TheDuck0s/isa_FDC-CF-USB/isa_FDC-CF-USB_Schematic.pdf

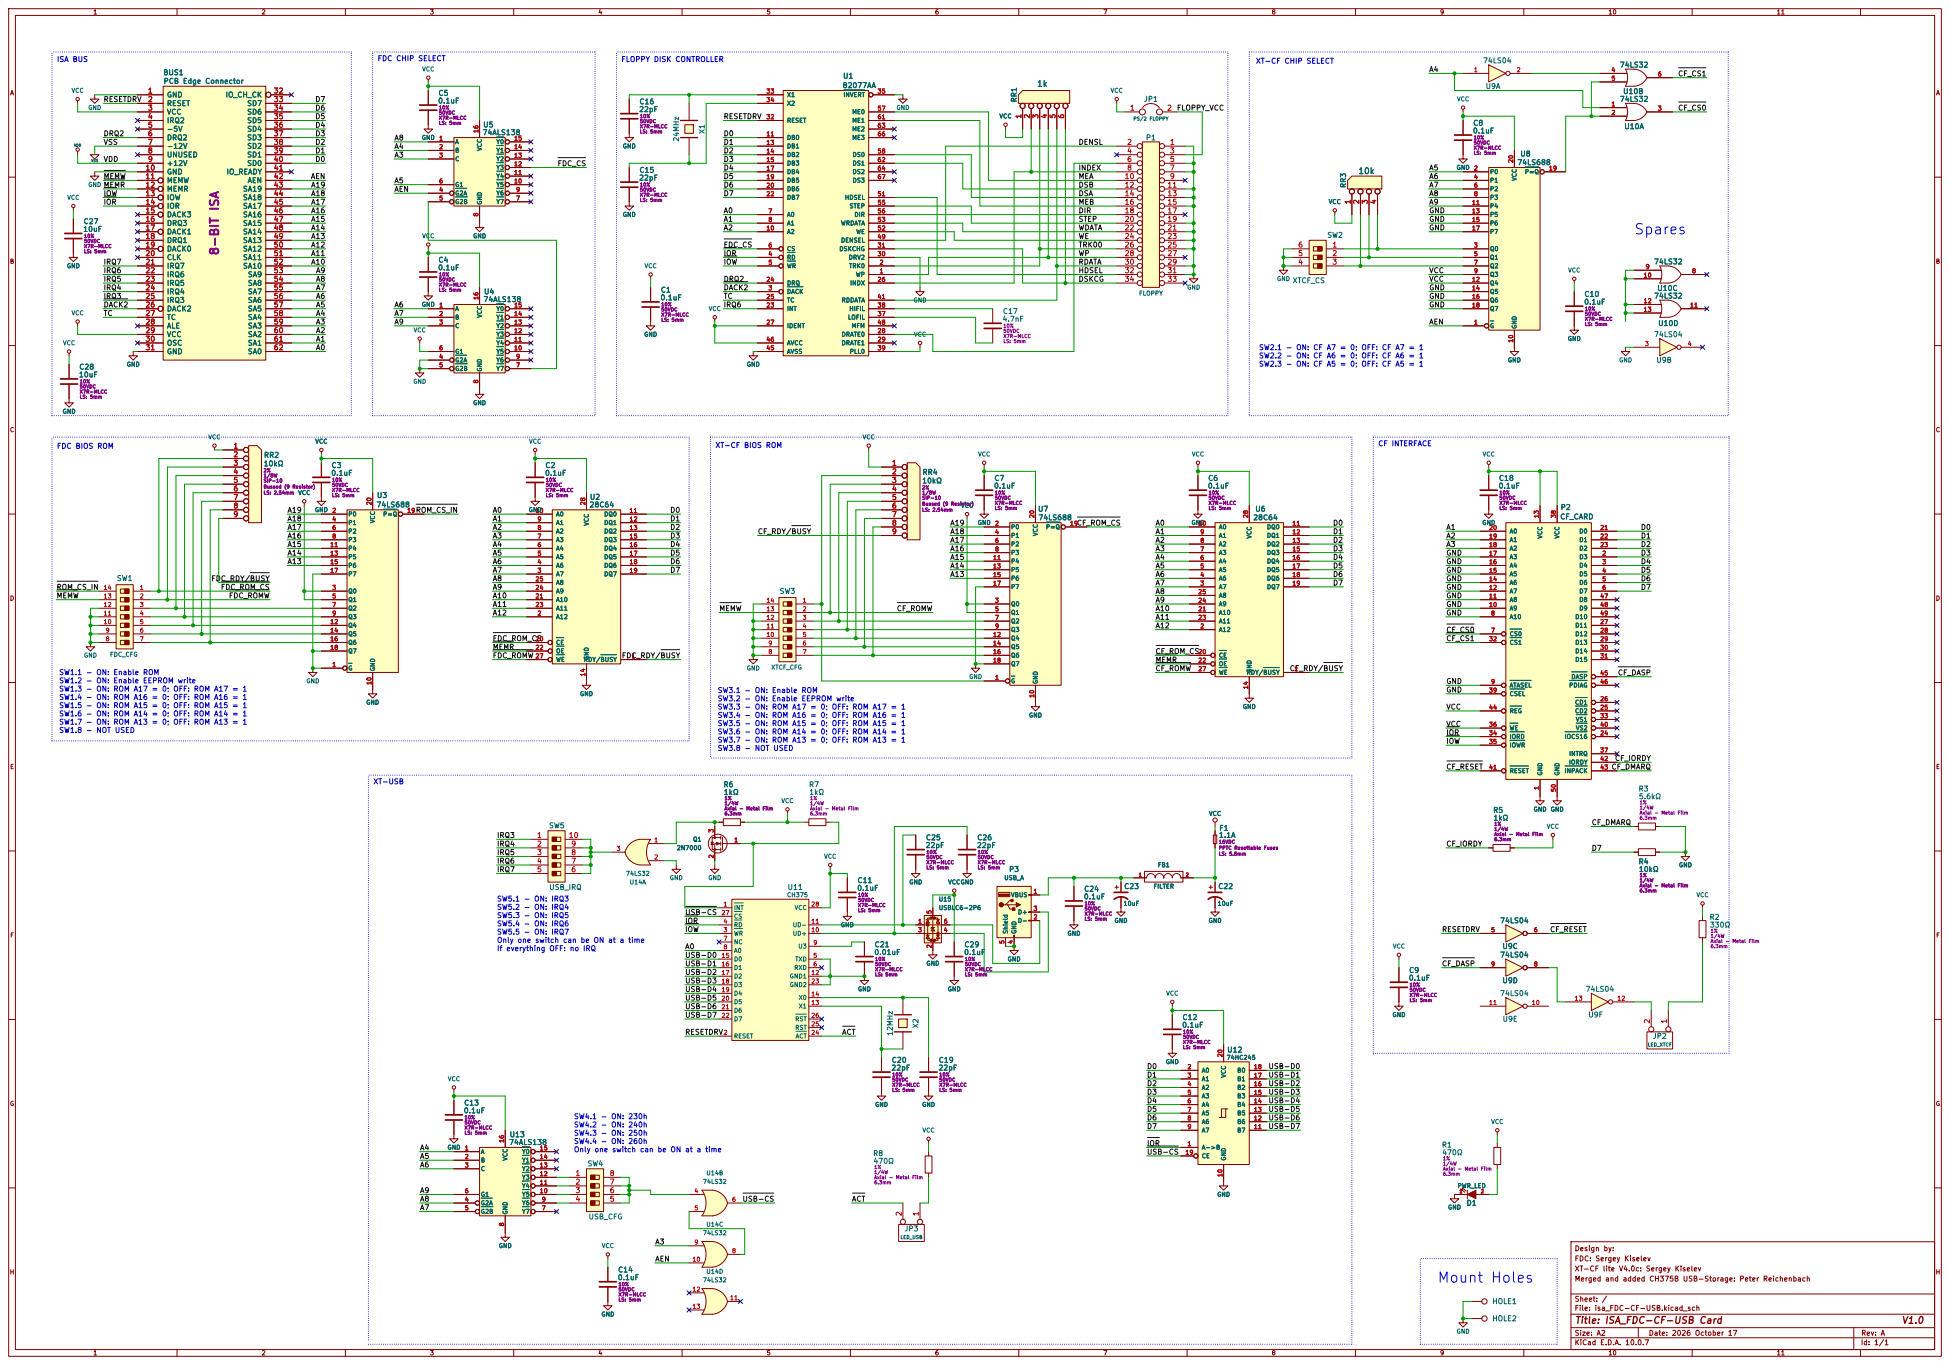
[picture p2: page 1]

PCB Edge Connector 8-BIT ISA

GND 1
RESET 2

XT-CF CHIP SELECT

SW2.1 - ON: CF A7 = 0; OFF: CF A7 = 1
SW2.2 - ON: CF A6 = 0; OFF: CF A6 = 1
SW2.3 - ON: CF A5 = 0; OFF: CF A5 = 1

XT-CF BIOS ROM

11 | 4
10 | 5

12 | 3

SW1.1 - ON: Enable ROM
SW1.2 - ON: Enable EEPROM write
SW1.3 - ON: ROM A17 = 0; OFF: ROM A17 = 1
SW1.4 - ON: ROM A16 = 0; OFF: ROM A16 = 1
SW1.5 - ON: ROM A15 = 0; OFF: ROM A15 = 1
SW1.6 - ON: ROM A14 = 0; OFF: ROM A14 = 1
SW1.7 - ON: ROM A13 = 0; OFF: ROM A13 = 1
SW1.8 - NOT USED

SW3.1 - ON: Enable ROM
SW3.2 - ON: Enable EEPROM write
SW3.3 - ON: ROM A17 = 0; OFF: ROM A17 = 1
SW3.4 - ON: ROM A16 = 0; OFF: ROM A16 = 1
SW3.5 - ON: ROM A15 = 0; OFF: ROM A15 = 1
SW3.6 - ON: ROM A14 = 0; OFF: ROM A14 = 1
SW3.7 - ON: ROM A13 = 0; OFF: ROM A13 = 1
SW3.8 - NOT USED

SW5.1 - ON: IRQ3
SW5.2 - ON: IRQ4
SW5.3 - ON: IRQ5
SW5.4 - ON: IRQ6
SW5.5 - ON: IRQ7
Only one switch can be ON at a time
If everything OFF: no IRQ

Design by:
FDC: Sergey Kiselev
XT-CF lite V4.0c: Sergey Kiselev
Merged and added CH375B USB-Storage: Peter Reichenbach

Size: A2 | Rev: A
KiCad E.D.A. 10.0.7 | Id: 1/1
