TheDuck0s/isa_FDC-CF-USB/isa_FDC-CF-USB_Board_Design.pdf

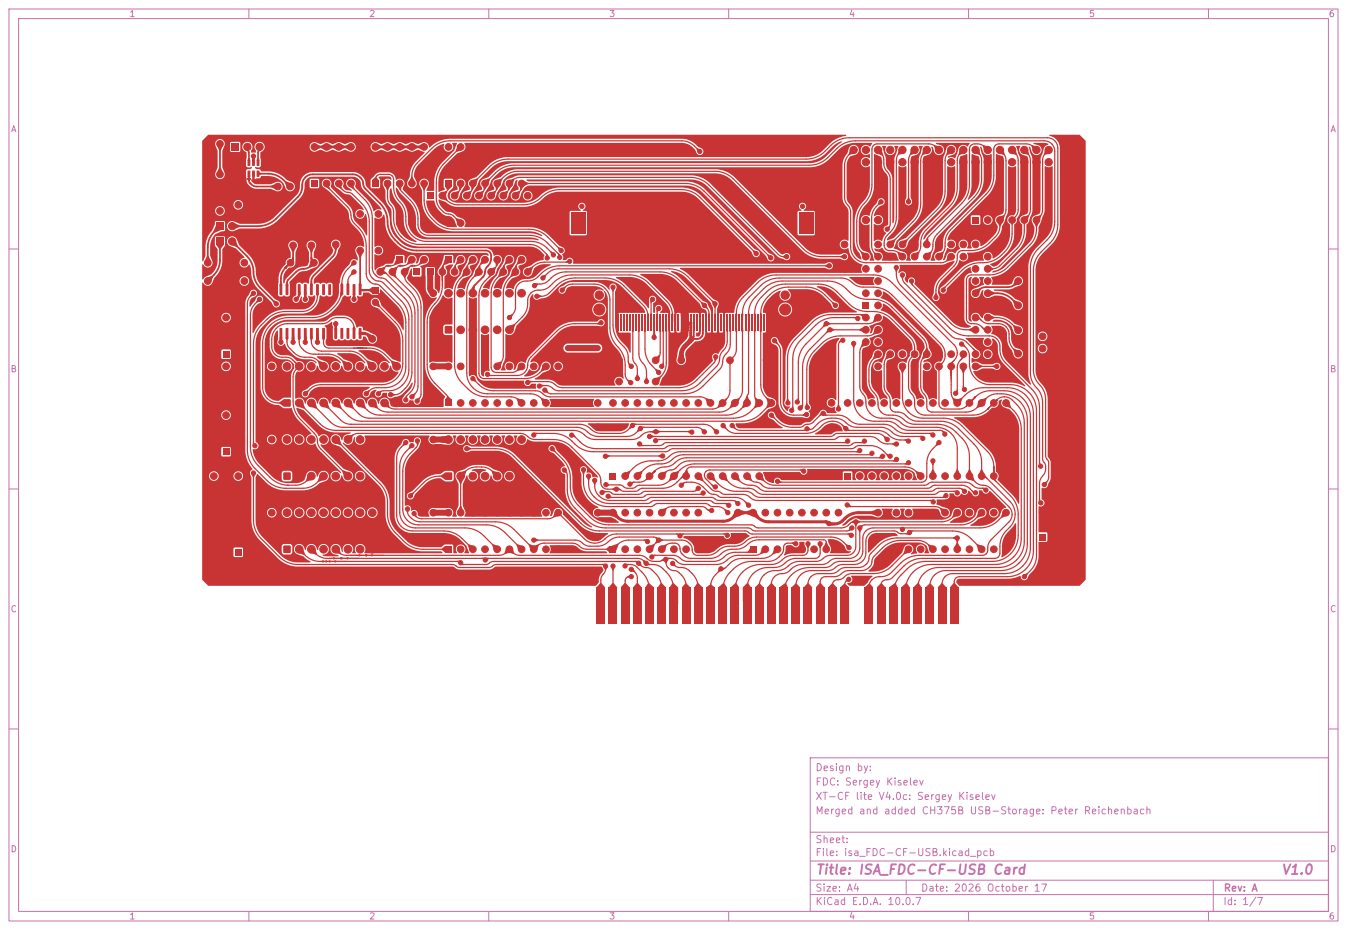
[picture p3: page 1]

Design by:
FDC: Sergey Kiselev
XT-CF lite V4.0c: Sergey Kiselev
Merged and added CH375B USB-Storage: Peter Reichenbach

Size: A4 | Rev: A
KiCad E.D.A. 10.0.7 | Id: 1/7

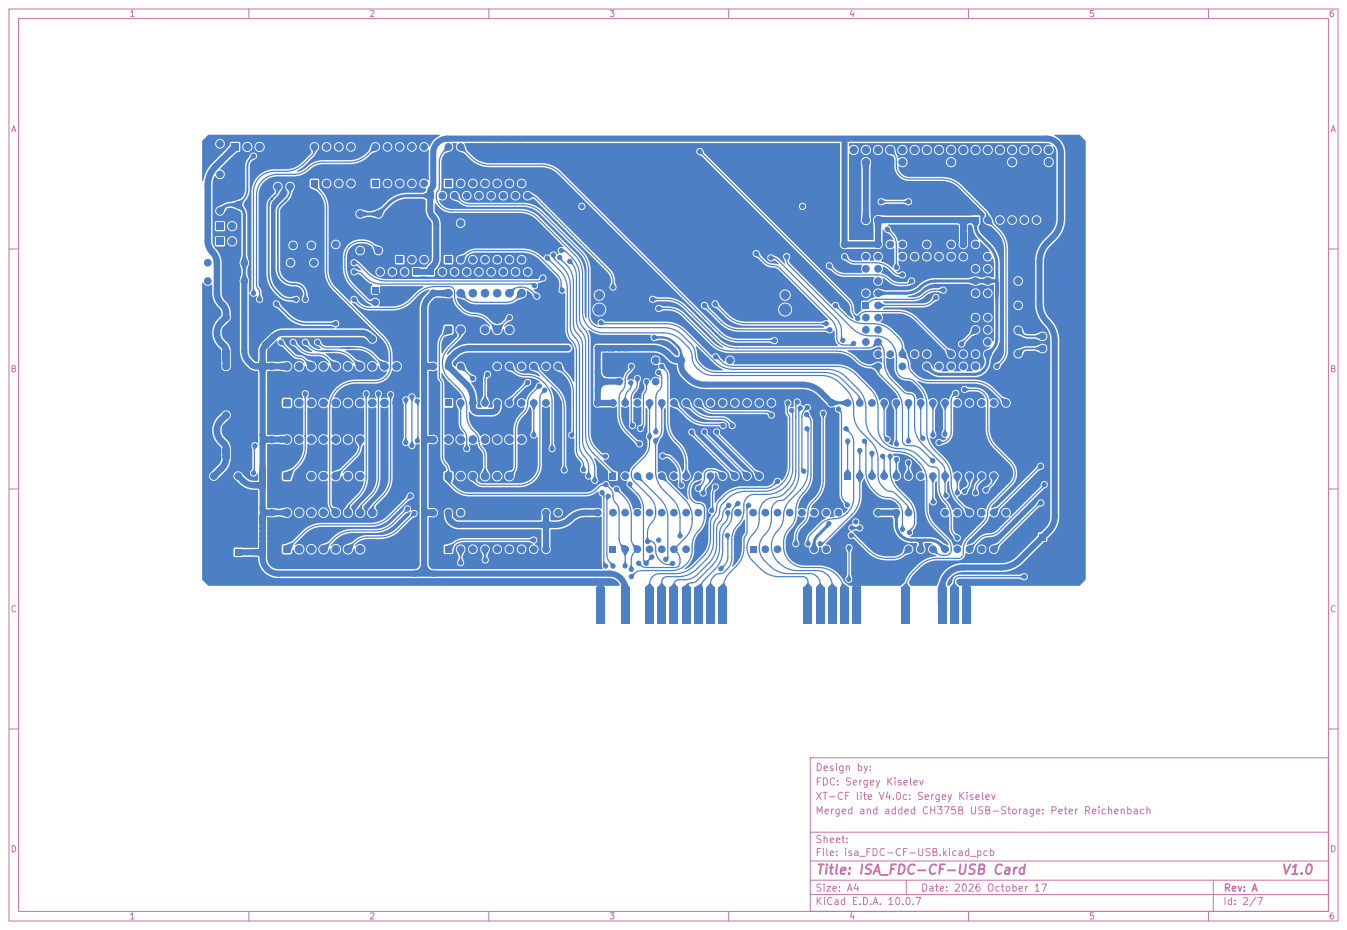
[picture p4: page 2]
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

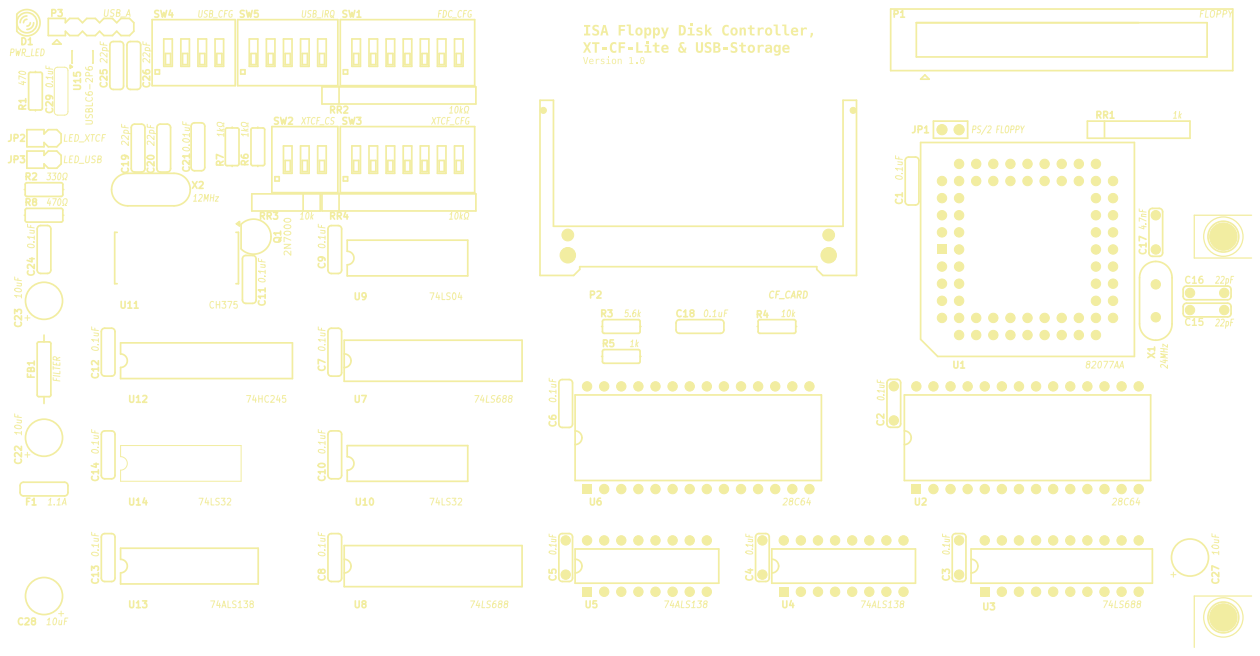
[picture p5: page 3]
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

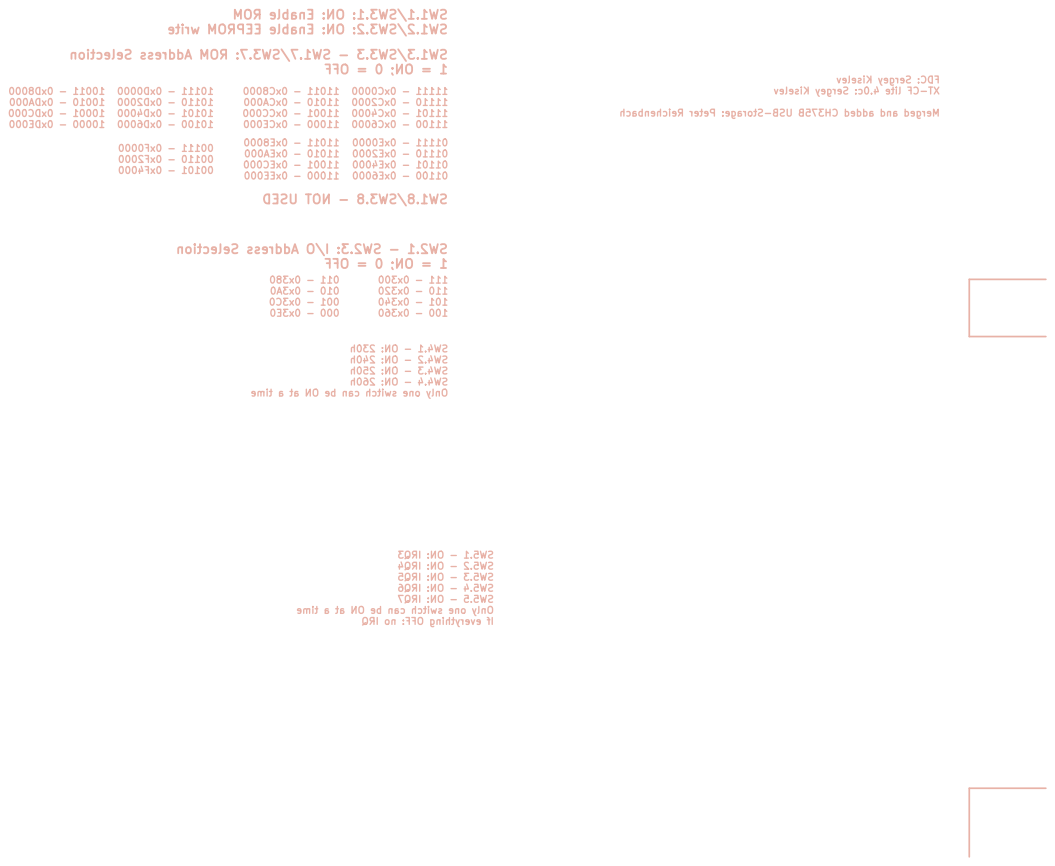
[picture p6: page 4]
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

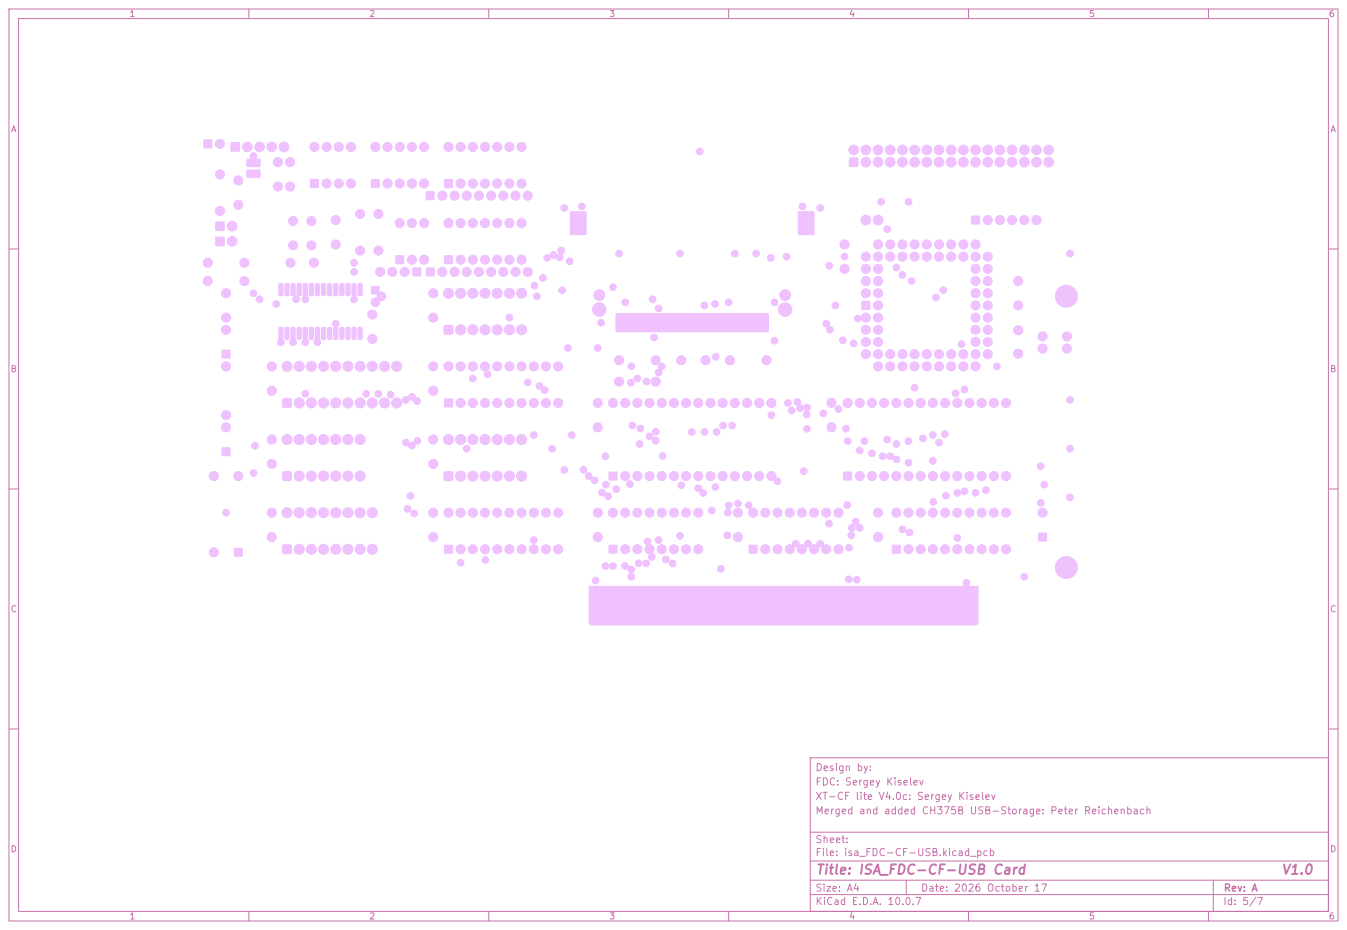
[picture p7: page 5]
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

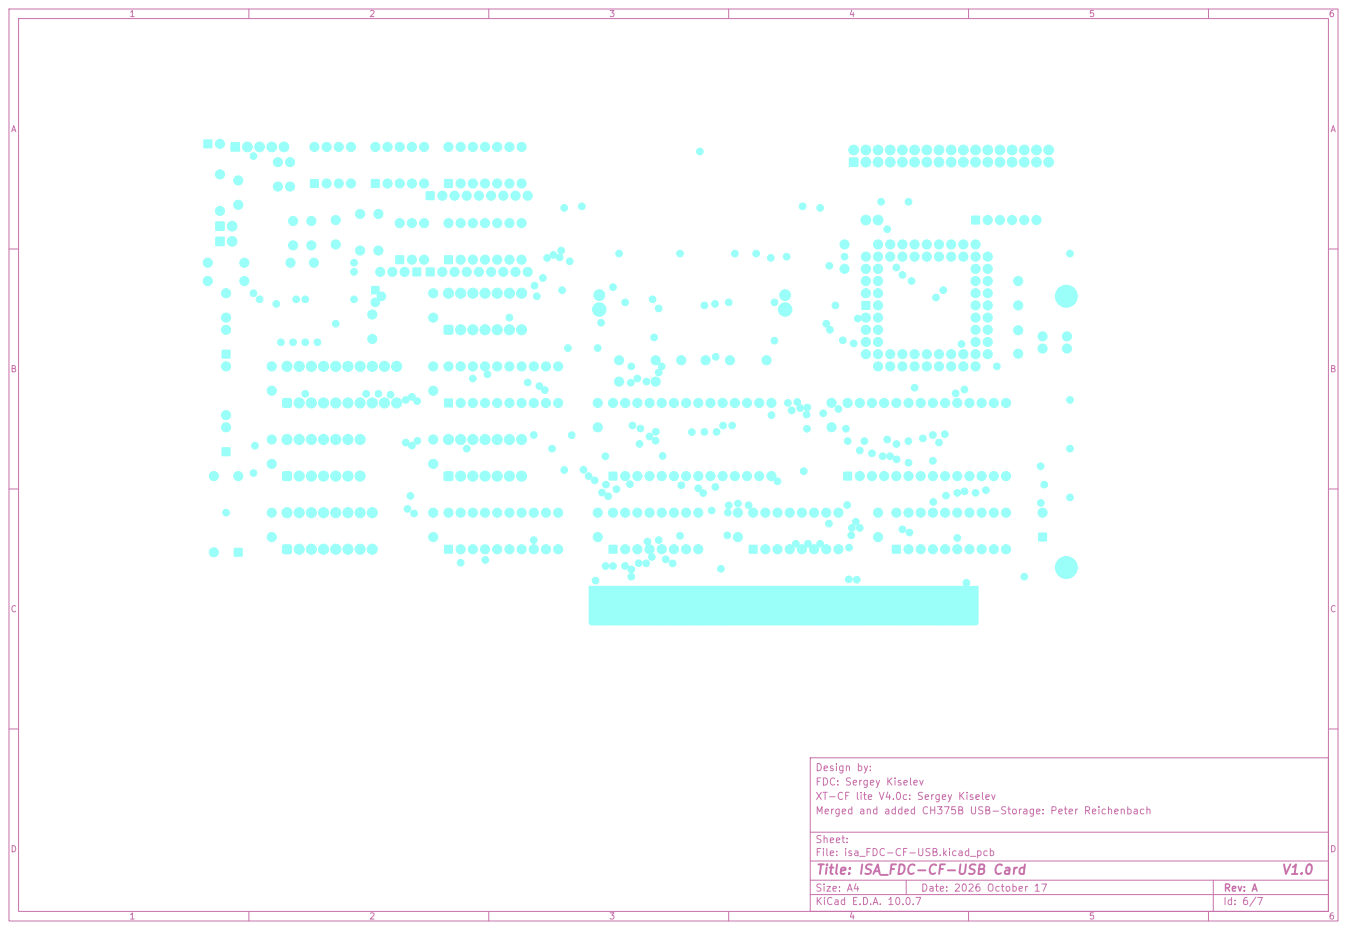
[picture p8: page 6]
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

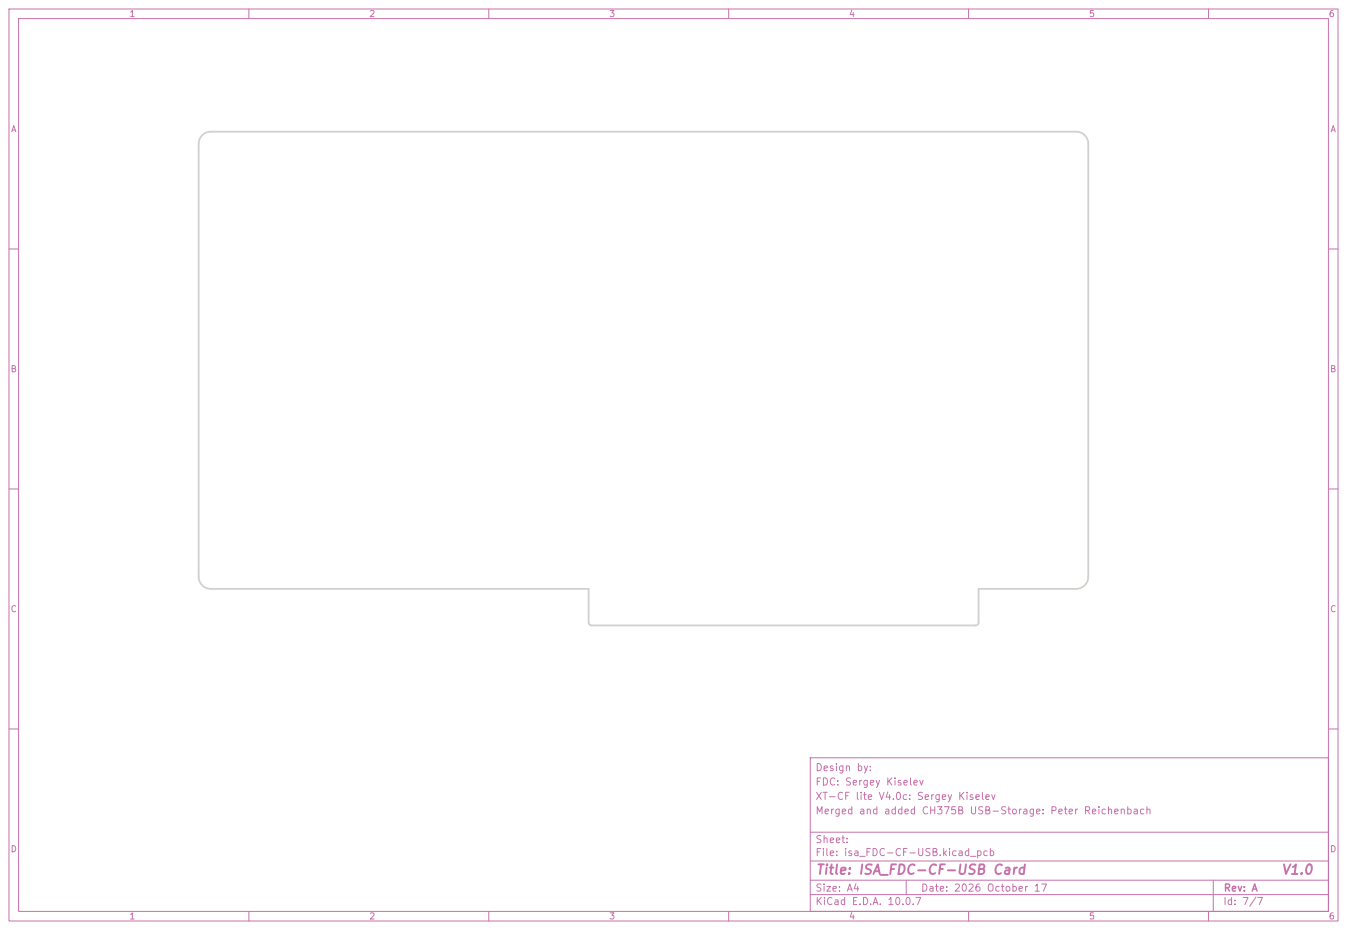
[picture p9: page 7]
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
