TheDuck0s/isa_FDC-CF-USB/Kicad/isa_FDC-CF-USB.kicad_pcb

## KiCad design Kicad/isa_FDC-CF-USB.kicad_pcb (2026-10-17)

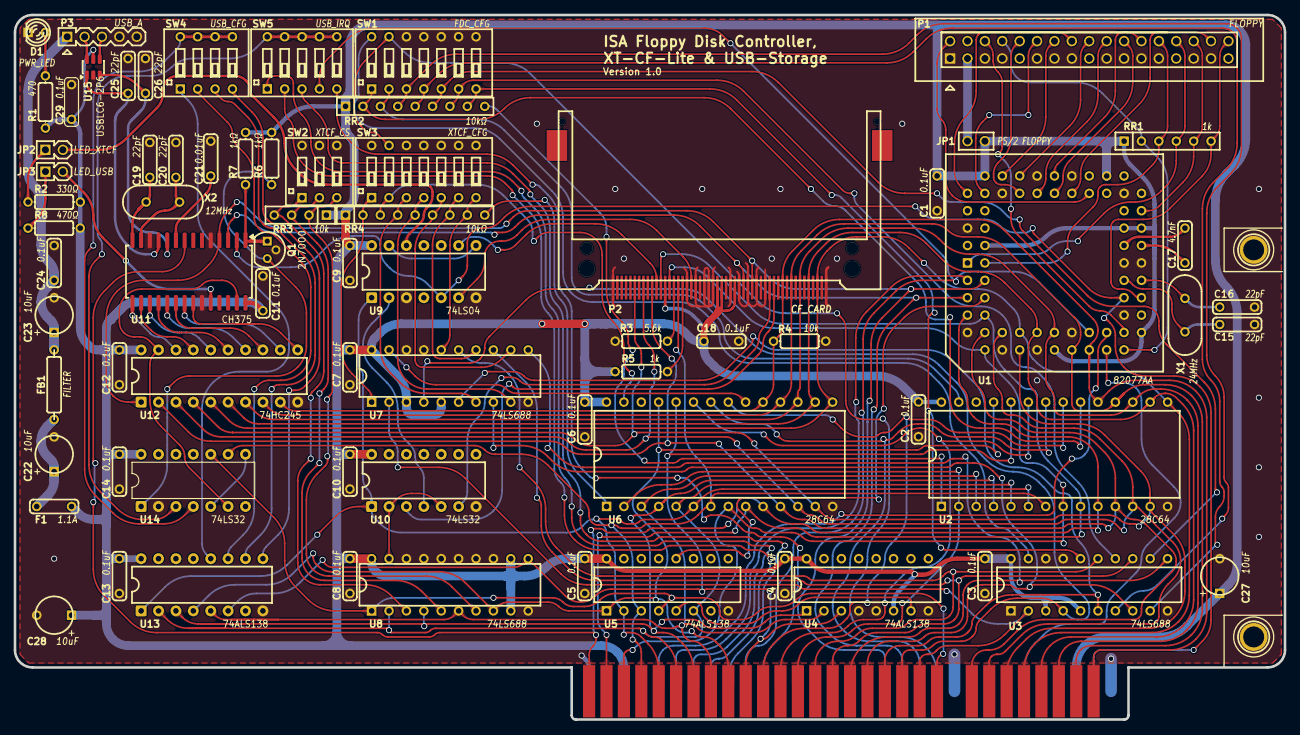
[picture p10: board isa_FDC-CF-USB.kicad_pcb from above]

Board: 2 copper layers, 185.4 x 102.9 mm, 76 parts (0 on the bottom side), 130 nets.

Parts:
BUS1: PCB Edge Connector; Conn_Bus_ISA8
C1, C6, C7, C8, C9, C10, C11, C12, C13, C14, C18, C24, C29: 0.1uF; Cap_Cer_508
C2, C3, C4, C5: 0.1uF; Cap_Cer_504
C15, C16: 22pF; Cap_Cer_504
C17: 4.7nF; Cap_Cer_504
C19, C20, C25, C26: 22pF; Cap_Cer_508
C21: 0.01uF; Cap_Cer_508
C22, C23, C27, C28: 10uF; Cap_Tant_508
D1: PWR_LED; LED_3mm
F1: 1.1A; Cap_Cer_508
FB1: FILTER; Res_1016
HOLE1, HOLE2: CONN_1; HOLE_3MM
JP1: PS/2 FLOPPY; Conn_Pin_Header_2x1_Nokey
JP2: LED_XTCF; Conn_Pin_Header_2x1_2.54mm
JP3: LED_USB; Conn_Pin_Header_2x1_2.54mm
P1: FLOPPY; Conn_Pin_Header_17x2_2.54mm_Shrouded
P2: CF_CARD; Conn_CF_N7E50-Q516XX-40
P3: USB_A; Conn_Pin_Header_5x1_2.54mm
Q1: 2N7000; TO-92
R1: 470; Res_762
R2: 330Ω; Res_762
R3: 5.6k; Res_762
R4: 10k; Res_762
R5: 1k; Res_762
R6, R7: 1kΩ; Res_762
R8: 470Ω; Res_762
RR1: 1k; Conn_SIL6
RR2, RR4: 10kΩ; Conn_SIL9
RR3: 10k; Conn_SIL5
SW1: FDC_CFG; Switch_DIP_7_Positions
SW2: XTCF_CS; Switch_DIP_3_Positions
SW3: XTCF_CFG; Switch_DIP_7_Positions
SW4: USB_CFG; Switch_DIP_4_Positions
SW5: USB_IRQ; Switch_DIP_5_Positions
U1: 82077AA; PLCC68_TH
U2: 28C64; DIP28_600
U3: 74LS688; DIP20_300
U4, U5: 74ALS138; DIP16_300
U6: 28C64; IC_DIP28_600
U7, U8: 74LS688; IC_DIP20_300
U9: 74LS04; DIP-14_W7.62mm
U10, U14: 74LS32; DIP-14_W7.62mm
U11: CH375; SOP-28_8.4x18.16mm_P1.27mm
U12: 74HC245; DIP-20_W7.62mm
U13: 74ALS138; DIP-16_W7.62mm
U15: USBLC6-2P6; SOT-23-6
X1: 24MHz; Crystal_HC-49U_Vert
X2: 12MHz; Crystal_HC-49U_Vert

Connections:
/A0: BUS1.62 (SA0), U1.7 (A0), U2.10 (A0), U6.10 (A0), U11.8 (A0)
/A1: BUS1.61 (SA1), P2.20 (A0), U1.8 (A1), U2.9 (A1), U6.9 (A1)
/A2: BUS1.60 (SA2), P2.19 (A1), U1.10 (A2), U2.8 (A2), U6.8 (A2)
/A3: BUS1.59 (SA3), P2.18 (A2), U2.7 (A3), U5.3 (C), U6.7 (A3), U14.9
/A4: BUS1.58 (SA4), U2.6 (A4), U5.2 (B), U6.6 (A4), U9.1, U10.1, U13.1 (A)
/A5: BUS1.57 (SA5), U2.5 (A5), U5.6 (G1), U6.5 (A5), U8.2 (P0), U13.2 (B)
/A6: BUS1.56 (SA6), U2.4 (A6), U4.1 (A), U6.4 (A6), U8.4 (P1), U13.3 (C)
/A7: BUS1.55 (SA7), U2.3 (A7), U4.2 (B), U6.3 (A7), U8.6 (P2), U13.5 (~G2B)
/A8: BUS1.54 (SA8), U2.25 (A8), U5.1 (A), U6.25 (A8), U8.8 (P3), U13.4 (~G2A)
/A9: BUS1.53 (SA9), U2.24 (A9), U4.3 (C), U6.24 (A9), U8.11 (P4), U13.6 (G1)
/A10: BUS1.52 (SA10), U2.21 (A10), U6.21 (A10)
/A11: BUS1.51 (SA11), U2.23 (A11), U6.23 (A11)
/A12: BUS1.50 (SA12), U2.2 (A12), U6.2 (A12)
/A13: BUS1.49 (SA13), U3.15 (P6), U7.15 (P6)
/A14: BUS1.48 (SA14), U3.13 (P5), U7.13 (P5)
/A15: BUS1.47 (SA15), U3.11 (P4), U7.11 (P4)
/A16: BUS1.46 (SA16), U3.8 (P3), U7.8 (P3)
/A17: BUS1.45 (SA17), U3.6 (P2), U7.6 (P2)
/A18: BUS1.44 (SA18), U3.4 (P1), U7.4 (P1)
/A19: BUS1.43 (SA19), U3.2 (P0), U7.2 (P0)
/AEN: BUS1.42 (AEN), U5.4 (~G2A), U8.1 (~G), U14.10
/CF_DMARQ: P2.43 (~INPACK), R3.1
/CF_IORDY: P2.42 (IORDY), R5.1
/CF_RDY/~BUSY: RR4.9, U6.1 (RDY/~BUSY)
/D0: BUS1.40 (SD0), P2.21 (D0), U1.11 (DB0), U2.11 (DQ0), U6.11 (DQ0), U12.2 (A0)
/D1: BUS1.39 (SD1), P2.22 (D1), U1.13 (DB1), U2.12 (DQ1), U6.12 (DQ1), U12.3 (A1)
/D2: BUS1.38 (SD2), P2.23 (D2), U1.14 (DB2), U2.13 (DQ2), U6.13 (DQ2), U12.4 (A2)
/D3: BUS1.37 (SD3), P2.2 (D3), U1.15 (DB3), U2.15 (DQ3), U6.15 (DQ3), U12.5 (A3)
/D4: BUS1.36 (SD4), P2.3 (D4), U1.17 (DB4), U2.16 (DQ4), U6.16 (DQ4), U12.6 (A4)
/D5: BUS1.35 (SD5), P2.4 (D5), U1.19 (DB5), U2.17 (DQ5), U6.17 (DQ5), U12.7 (A5)
/D6: BUS1.34 (SD6), P2.5 (D6), U1.20 (DB6), U2.18 (DQ6), U6.18 (DQ6), U12.8 (A6)
/D7: BUS1.33 (SD7), P2.6 (D7), R4.1, U1.22 (DB7), U2.19 (DQ7), U6.19 (DQ7), U12.9 (A7)
/DENSL: P1.2, U1.49 (DENSEL)
/DIR: P1.18, U1.56 (DIR)
/DRQ2: BUS1.6 (DRQ2), U1.24 (DRQ)
/DSA: P1.14, U1.58 (DS0)
/DSB: P1.12, U1.62 (DS1)
/DSKCG: P1.34, RR1.6, U1.31 (DSKCHG)
/FDC_RDY/~BUSY: RR2.9, U2.1 (RDY/~BUSY)
/FLOPPY_VCC: JP1.2, P1.3
/HDSEL: P1.32, U1.51 (HDSEL)
/INDEX: P1.8, RR1.2, U1.26 (INDX)
/IRQ3: BUS1.25 (IRQ3), SW5.1
/IRQ4: BUS1.24 (IRQ4), SW5.2
/IRQ5: BUS1.23 (IRQ5), SW5.3
/IRQ6: BUS1.22 (IRQ6), SW5.4, U1.23 (INT)
/IRQ7: BUS1.21 (IRQ7), SW5.5
/MEA: P1.10, U1.57 (ME0)
/MEB: P1.16, U1.61 (ME1)
/RDATA: P1.30, RR1.5, U1.41 (RDDATA)
/RESETDRV: BUS1.2 (RESET), U1.32 (RESET), U9.5, U11.2 (RESET)
/STEP: P1.20, U1.55 (STEP)
/TC: BUS1.27 (TC), U1.25 (TC)
/TRK00: P1.26, RR1.3, U1.2 (TRK0)
/USB-D0: U11.15 (D0), U12.18 (B0)
/USB-D1: U11.16 (D1), U12.17 (B1)
/USB-D2: U11.17 (D2), U12.16 (B2)
/USB-D3: U11.18 (D3), U12.15 (B3)
/USB-D4: U11.19 (D4), U12.14 (B4)
/USB-D5: U11.20 (D5), U12.13 (B5)
/USB-D6: U11.21 (D6), U12.12 (B6)
/USB-D7: U11.22 (D7), U12.11 (B7)
/WDATA: P1.22, U1.53 (WRDATA)
/WE: P1.24, U1.52 (WE)
/WP: P1.28, RR1.4, U1.1 (WP)
/~ACT: JP3.2 (PM), U11.24 (~ACT)
/~CF_CS0: P2.7 (~CS0), U10.3
/~CF_CS1: P2.32 (~CS1), U10.6
/~CF_DASP: P2.45 (~DASP), U9.9
/~CF_RESET: P2.41 (~RESET), U9.6
/~CF_ROMW: RR4.3, SW3.2, U6.27 (~WE)
/~CF_ROM_CS: U6.20 (~CE), U7.19 (~P=Q)
/~DACK2: BUS1.26 (DACK2), U1.3 (~DACK)
/~FDC_CS: U1.6 (CS), U5.12 (~Y3)
/~FDC_ROMW: RR2.3, SW1.2, U2.27 (~WE)
/~FDC_ROM_CS: RR2.2, SW1.1, U2.20 (~CE)
/~IOR: BUS1.14 (IOR), P2.34 (~IORD), U1.4 (~RD), U11.4 (~RD), U12.1 (A->B)
/~IOW: BUS1.13 (IOW), P2.35 (~IOWR), U1.5 (~WR), U11.3 (~WR)
/~MEMR: BUS1.12 (MEMR), U2.22 (~OE), U6.22 (~OE)
/~MEMW: BUS1.11 (MEMW), SW1.13, SW3.13
/~ROM_CS_IN: SW1.14, U3.19 (~P=Q)
/~USB-CS: U11.27 (~CS), U12.19 (CE), U14.6
GND: BUS1.1 (GND), BUS1.10 (GND), BUS1.31 (GND), C1.2, C2.2, C3.2, C4.2, C5.2, C6.2, C7.2, C8.2, C9.2, C10.2, C11.1, C12.2, C13.2, C14.2, C15.2, C16.2, C18.2, C19.2, C20.2, C21.2, C22.2, C23.2, C24.2, C25.2, C26.2, C27.2, C28.2, C29.2, D1.1 (K), HOLE1.1 (1_1), HOLE2.1 (1_1), P1.1, P1.5, P1.7, P1.11, P1.13, P1.15, P1.19, P1.21, P1.23, P1.25, P1.29, P1.31, P2.1 (GND), P2.8 (A10), P2.9 (~ATASEL), P2.10 (A9), P2.11 (A8), P2.12 (A7), P2.14 (A6), P2.15 (A5), P2.16 (A4), P2.17 (A3), P2.39 (~CSEL), P2.50 (GND), P3.4 (GND), P3.5 (Shield), Q1.2 (S), R3.2, R4.2, SW1.8, SW1.9, SW1.10, SW1.11, SW1.12, SW2.4, SW2.5, SW2.6, SW3.8, SW3.9, SW3.10, SW3.11, SW3.12, SW3.14, U1.9 (GND), U1.12 (GND), U1.16 (GND), U1.21 (GND), U1.30 (DRV2), U1.35 (~INVERT), U1.36 (GND), U1.45 (AVSS), U1.50 (GND), U1.54 (GND), U1.59 (GND), U1.65 (GND), U2.14 (GND), U3.1 (~G), U3.10 (GND), U3.17 (P7), U3.18 (Q7), U4.4 (~G2A), U4.5 (~G2B), U4.8 (GND), U5.8 (GND), U6.14 (GND), U7.10 (GND), U7.17 (P7), U7.18 (Q7), U8.10 (GND), U8.13 (P5), U8.14 (Q5), U8.15 (P6), U8.16 (Q6), U8.17 (P7), U8.18 (Q7), U9.3, U9.7 (GND), U10.7 (GND), U11.5 (TXD), U11.12 (GND1), U11.23 (GND2), U12.10 (GND), U13.8 (GND), U14.2, U15.2 (GND)
unnamed: C22.1, F1.1, FB1.2
unnamed: D1.2 (A), R1.1
unnamed: JP2.1, R2.2
unnamed: JP2.2 (PM), U9.12
unnamed: JP3.1, R8.2
unnamed: P1.6, U1.28 (DRATE0)
unnamed: P3.3 (D+), U15.4 (I/O2)
unnamed: P3.2 (D-), U15.6 (I/O1)
unnamed: C23.1, C24.1, FB1.1, P3.1 (VBUS)
unnamed: Q1.3 (D), R6.2, U14.1
unnamed: Q1.1 (G), R7.1, U11.1 (~INT)
unnamed: SW4.5, SW4.6, SW4.7, SW4.8, U14.4
unnamed: SW5.6, SW5.7, SW5.8, SW5.9, SW5.10, U14.3
unnamed: C17.1, U1.38 (HIFIL)
unnamed: C17.2, U1.37 (LOFIL)
unnamed: C16.1, U1.33 (X1), X1.1
unnamed: C15.1, U1.34 (X2), X1.2
unnamed: RR2.4, SW1.3, U3.7 (Q2)
unnamed: RR2.5, SW1.4, U3.9 (Q3)
unnamed: RR2.6, SW1.5, U3.12 (Q4)
unnamed: RR2.7, SW1.6, U3.14 (Q5)
unnamed: RR2.8, SW1.7, U3.16 (Q6)
unnamed: U4.7 (~Y7), U5.5 (~G2B)
unnamed: RR4.4, SW3.3, U7.7 (Q2)
unnamed: RR4.5, SW3.4, U7.9 (Q3)
unnamed: RR4.6, SW3.5, U7.12 (Q4)
unnamed: RR4.7, SW3.6, U7.14 (Q5)
unnamed: RR4.8, SW3.7, U7.16 (Q6)
unnamed: RR4.2, SW3.1, U7.1 (~G)
unnamed: RR3.4, SW2.1, U8.3 (Q0)
unnamed: RR3.3, SW2.2, U8.5 (Q1)
unnamed: RR3.2, SW2.3, U8.7 (Q2)
unnamed: U8.19 (~P=Q), U10.2, U10.5
unnamed: U9.8, U9.13
unnamed: U9.2, U10.4
unnamed: U10.9, U10.10, U10.12, U10.13
unnamed: C21.1, U11.9 (U3)
unnamed: C26.1, U11.10 (UD+), U15.3 (I/O2)
unnamed: C25.1, U11.11 (UD-), U15.1 (I/O1)
unnamed: C19.1, U11.14 (X0), X2.1
unnamed: C20.1, U11.13 (X1), X2.2
unnamed: SW4.1, U13.12 (~Y3)
unnamed: SW4.2, U13.11 (~Y4)
unnamed: SW4.3, U13.10 (~Y5)
unnamed: SW4.4, U13.9 (~Y6)
unnamed: U14.5, U14.8
VCC: BUS1.3 (VCC), BUS1.29 (VCC), C1.1, C2.1, C3.1, C4.1, C5.1, C6.1, C7.1, C8.1, C9.1, C10.1, C11.2, C12.1, C13.1, C14.1, C18.1, C27.1, C28.1, C29.1, F1.2, JP1.1, P2.13 (VCC), P2.36 (~WE), P2.38 (VCC), P2.44 (~REG), R1.2, R2.1, R5.2, R6.1, R7.2, R8.1, RR1.1 (COM), RR2.1 (COM), RR3.1 (COM), RR4.1 (COM), U1.18 (VCC), U1.27 (IDENT), U1.39 (PLL0), U1.40 (VCC), U1.46 (AVCC), U1.60 (VCC), U1.68 (VCC), U2.28 (VCC), U3.3 (Q0), U3.5 (Q1), U3.20 (VCC), U4.6 (G1), U4.16 (VCC), U5.16 (VCC), U6.28 (VCC), U7.3 (Q0), U7.5 (Q1), U7.20 (VCC), U8.9 (Q3), U8.12 (Q4), U8.20 (VCC), U9.14 (VCC), U10.14 (VCC), U11.28 (VCC), U12.20 (VCC), U13.16 (VCC), U15.5 (VBUS)
